Potato-eater/Legacy2026/README.md

# Legacy2026
github repo for Robocup Junior Australia lightweight soccer team

poster for state competition: https://canva.link/pb0ula68jbszzvj

All programs are annotated within their own files.
