Potato-eater/Legacy2026/robot_program/README.md

# legacy-robot-code
Legacy (RCJ Australian lightweight team)
repo for current robot code

Convention:
* all angles in radians (-PI - PI)
* all distance measurements in mm
* origin (0, 0) is centre of field

Note: 
* run "pio pkg update" to update all packages (SparkFun library requires latest version)
* ultrasonic classes have not been tested
