Potato-eater/Legacy2026/esp_programs/README.md

- all the programs that we have for the esp32 s2 units in the robot.
- the program for the ir sensor and line sensor.
- the other 2 programs are temporary testing projects. it can be ignored.
