Potato-eater/Legacy2026/pcbs/main_pcb_v2/production/bom.csv

Designator | Footprint | Quantity | Value | LCSC Part #
BT1, BT2, BT3 | Altronics_S5037 | 3 | 18650
C1 | 0805 | 1 | 10uF
C10 | 0402 | 1 | 0.1uF
C2, C3, C8, C9 | 0805 | 4 | 0.1uF
C4, C5 | 0805 | 2 | 22uF
C6 | 0805 | 1 | 75pF
CN1 | CONN-SMD_SM05B-SRSS-TB-LF-SN | 1 | MotorTL | C136657
CN2 | CONN-SMD_SM05B-SRSS-TB-LF-SN | 1 | MotorTR | C136657
CN3 | CONN-SMD_SM05B-SRSS-TB-LF-SN | 1 | MotorBL | C136657
CN4 | CONN-SMD_SM05B-SRSS-TB-LF-SN | 1 | MotorBR | C136657
CN5 | CONN-SMD_4P-P1.00_SM04B-SRSS-TB-LF-SN | 1 | OTOS | C160404
D1 | 0603 | 1 | MOTOR LED
D2, D5, D6, D7 | D_SMA | 4 | 1A Fast SMA
D3 | 0805 | 1 | OP LED
D4 | SMB_L4.6-W3.6-LS5.3-RD | 1 | SS34_C13762 | C13762
D8 | 0603 | 1 | MAIN LED
J1 | PinSocket_1x24_P2.54mm_Vertical | 1 | Teensy Left
J12 | PinSocket_1x06_P2.54mm_Vertical | 1 | BD Left
J13 | PinSocket_1x06_P2.54mm_Vertical | 1 | BD Right
J14 | JST_XH_B2B-XH-A_1x02_P2.50mm_Vertical | 1 | IR Sensor
J15 | JST_XH_B4B-XH-A_1x04_P2.50mm_Vertical | 1 | Line Sensor
J16 | JST_XH_B4B-XH-A_1x04_P2.50mm_Vertical | 1 | CAM
J17 | IDC-Header_2x05_P2.54mm_Vertical | 1 | Comm.
J2 | PinSocket_1x24_P2.54mm_Vertical | 1 | Teensy Right
J3 | PinSocket_1x05_P2.54mm_Vertical | 1 | EXTRA1
J4 | PinSocket_1x04_P2.54mm_Vertical | 1 | EXTRA2
J5 | PinSocket_1x04_P2.54mm_Vertical | 1 | EXTRA3
J6 | JST_XH_B2B-XH-A_1x02_P2.50mm_Vertical | 1 | DB_OUT
J7 | JST_XH_B2B-XH-A_1x02_P2.50mm_Vertical | 1 | EXTRA_I2C
J8 | PinSocket_1x03_P2.54mm_Vertical | 1 | Conn_01x03
L1 | IND-SMD_L11.0-W10.0 | 1 | 10uH
Q1 | WDFN-8_L3.0-W3.0-P0.65-LS3.3-BL-EP | 1 | AON7409 | C41348138
Q2 | DFN-8_L3.0-W3.0-P0.65-BL | 1 | AON7524 | C431195
R1 | 0603 | 1 | 49.9
R14, R7 | 0603 | 2 | 200R
R15, R2, R9 | 0603 | 3 | 100k
R3 | 0603 | 1 | 13.3k
R4 | 0603 | 1 | 511k
R5 | 0603 | 1 | 105k
R8 | 0603 | 1 | 33R
SW1, SW2, SW3 | CONN-TH_2P-P5.00_WJ128V-5.0-2P | 3 | SW_SPDT
U1 | SOT-23-6 | 1 | TPS54302
