Potato-eater/Legacy2026/pcbs/main_pcb/main_pcb.step

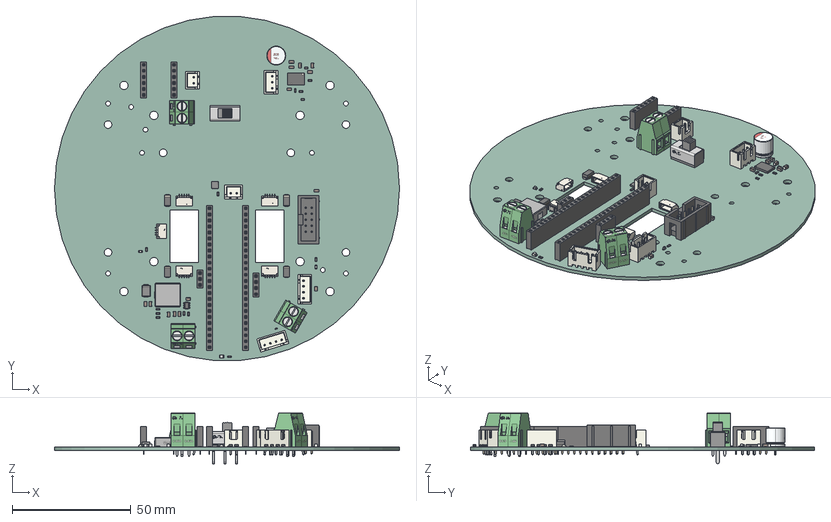
[picture p1: CAD file, 2026-09-28]
pcbs/main_pcb/main_pcb.step
145.0 x 144.6 x 21.2 mm
C_0805_2012Metric x 14
LED_0805_2012Metric
JST_XH_B2B-XH-A_1x02_P2.50mm_Vertical x 2
R_0603_1608Metric x 14
CONN-TH_2P-L10.0-W10.3-H14.1-P5.0 x 3
D_SMA x 4
SMB_L4.6-W3.6-LS5.3-RD
CONN-SMD_SR1.00-WS-5P x 4
LED_0603_1608Metric x 2
VQFN-40_L7.0-W5.0-P0.50-BL-EP5.7
IND-SMD_L11.0-W10.0-H4.0
PinSocket_1x06_P2.54mm_Vertical x 2
JST_XH_B4B-XH-A_1x04_P2.50mm_Vertical x 2
PinSocket_1x04_P2.54mm_Vertical
JST_XH_B3B-XH-A_1x03_P2.50mm_Vertical
CAP-TH_D8.0-H8.0-P3.50
SOT-23-6
SW-TH_SHOU-HAN_SS12D10G4
PinSocket_1x24_P2.54mm_Vertical x 2
DFN-8_L3.0-W3.0-H0.7-P0.65
IDC-Header_2x05_P2.54mm_Vertical
CONN-SMD_SR1.00-WS-4P
PinSocket_1x03_P2.54mm_Vertical
C_0402_1005Metric
main_pcb_PCB
