Potato-eater/Legacy2026/pcbs/control_board/control_board.step

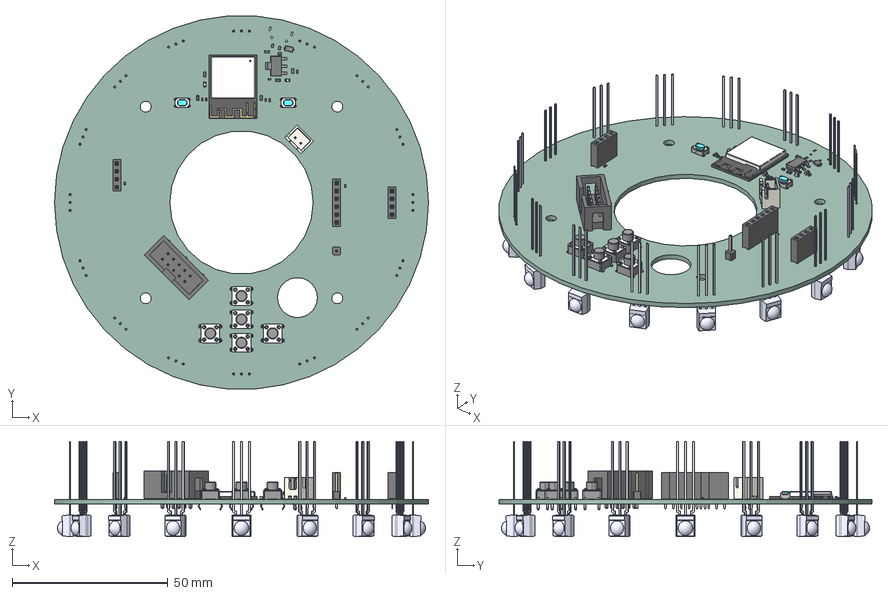
[picture p2: CAD file, 2026-09-28]
pcbs/control_board/control_board.step
120.0 x 119.7 x 30.5 mm
R_0603_1608Metric x 3
PinSocket_1x04_P2.54mm_Vertical x 2
LED_0603_1608Metric x 2
IDC-Header_2x05_P2.54mm_Vertical
MICRO-USB-SMD_5P-P0.65-H-F_C10418
JST_XH_B2B-XH-A_1x02_P2.50mm_Vertical
C_0402_1005Metric x 8
C_0603_1608Metric x 3
SOD-523_L1.2-W0.8-LS1.6-BI x 3
PinHeader_1x01_P2.54mm_Vertical
uid__9223372036865042093
R0201_20210301.xtd x 2
XTAL3225_20210301.xtd
L0201_20210301.xtd x 2
C0201_20210301.xtd x 15
ESP32-S2_20210301.xtd
DFN1006.xtd
C0402_20210301.xtd
Imported
MINI-ANT-TYPE-S-H_t
MINI-ANT-TYPE-S-H_b
ESP32-S3-S2-MINI-solder_pad
ShieldBox_ESP32-S2-MINI-1_V1.0_20200714
PinSocket_1x06_P2.54mm_Vertical
SW-SMD_4P_PTS810SJM250SMTRLFS x 2
SOD-123_L2.7-W1.6-H1.4-LS3.7
SOT-223
GO-100184_1 x 16
GO-100184.028 x 16
control_board_PCB
