Potato-eater/Legacy2026/(list of files, cad)

Other CAD files:
pcbs/control_board/control_board.stl
