Potato-eater/Legacy2026/pcbs/line_sensor/line_sensor.pdf

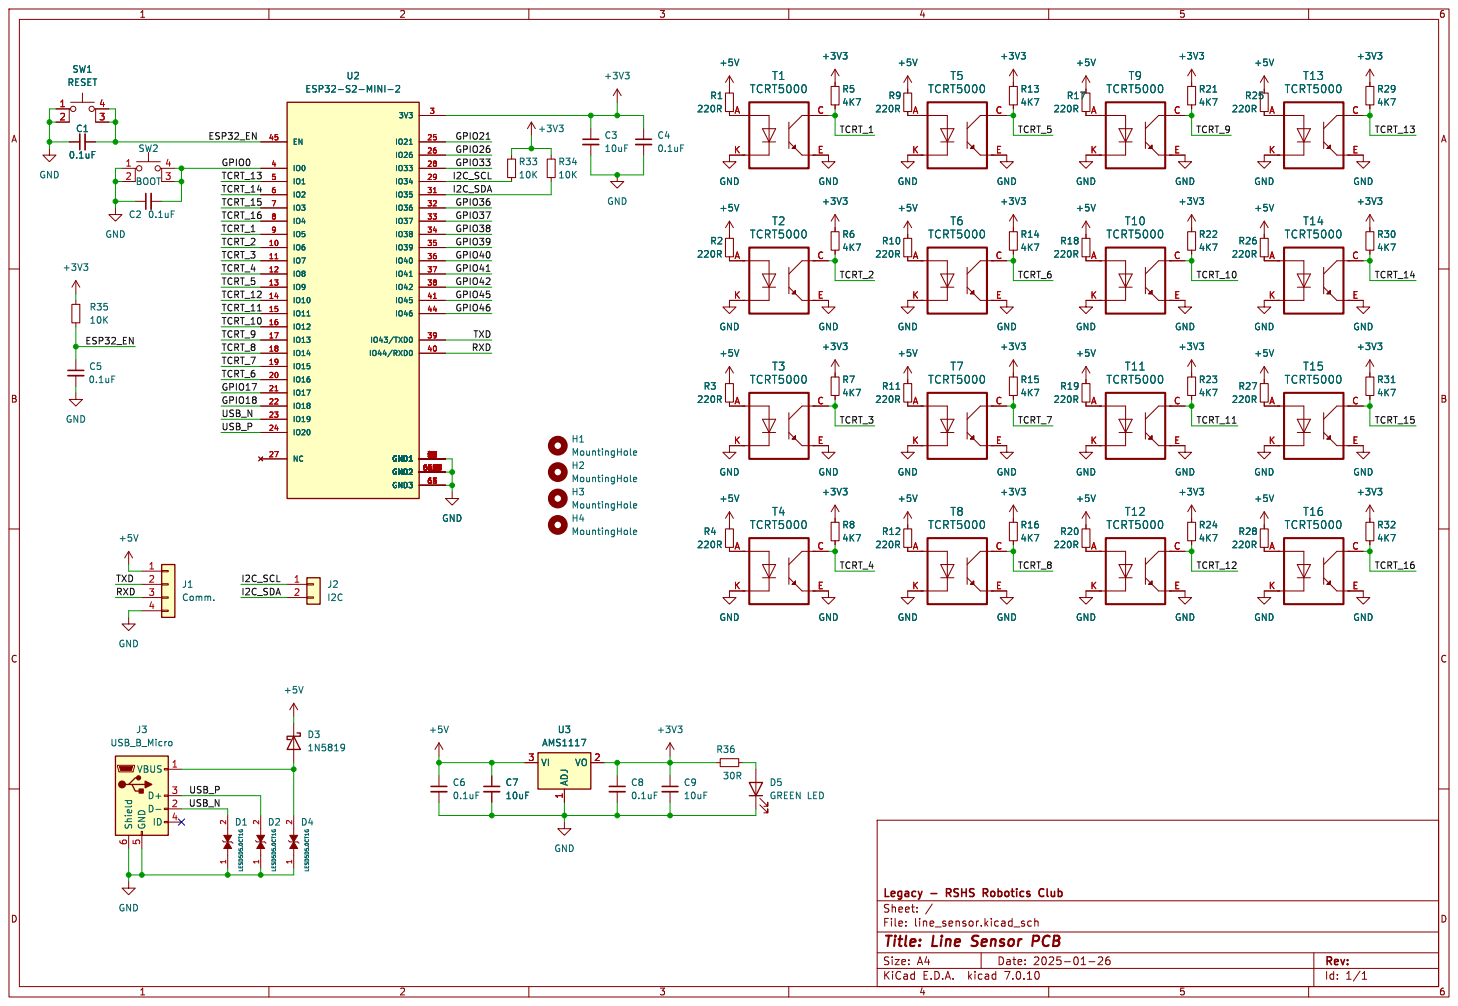
[picture p3: page 1]

Id: 1/1 Title: Line Sensor PCB
