Potato-eater/Legacy2026/pcbs/control_board/control_board.kicad_pcb

## KiCad design pcbs/control_board/control_board.kicad_pcb (2026-09-28)

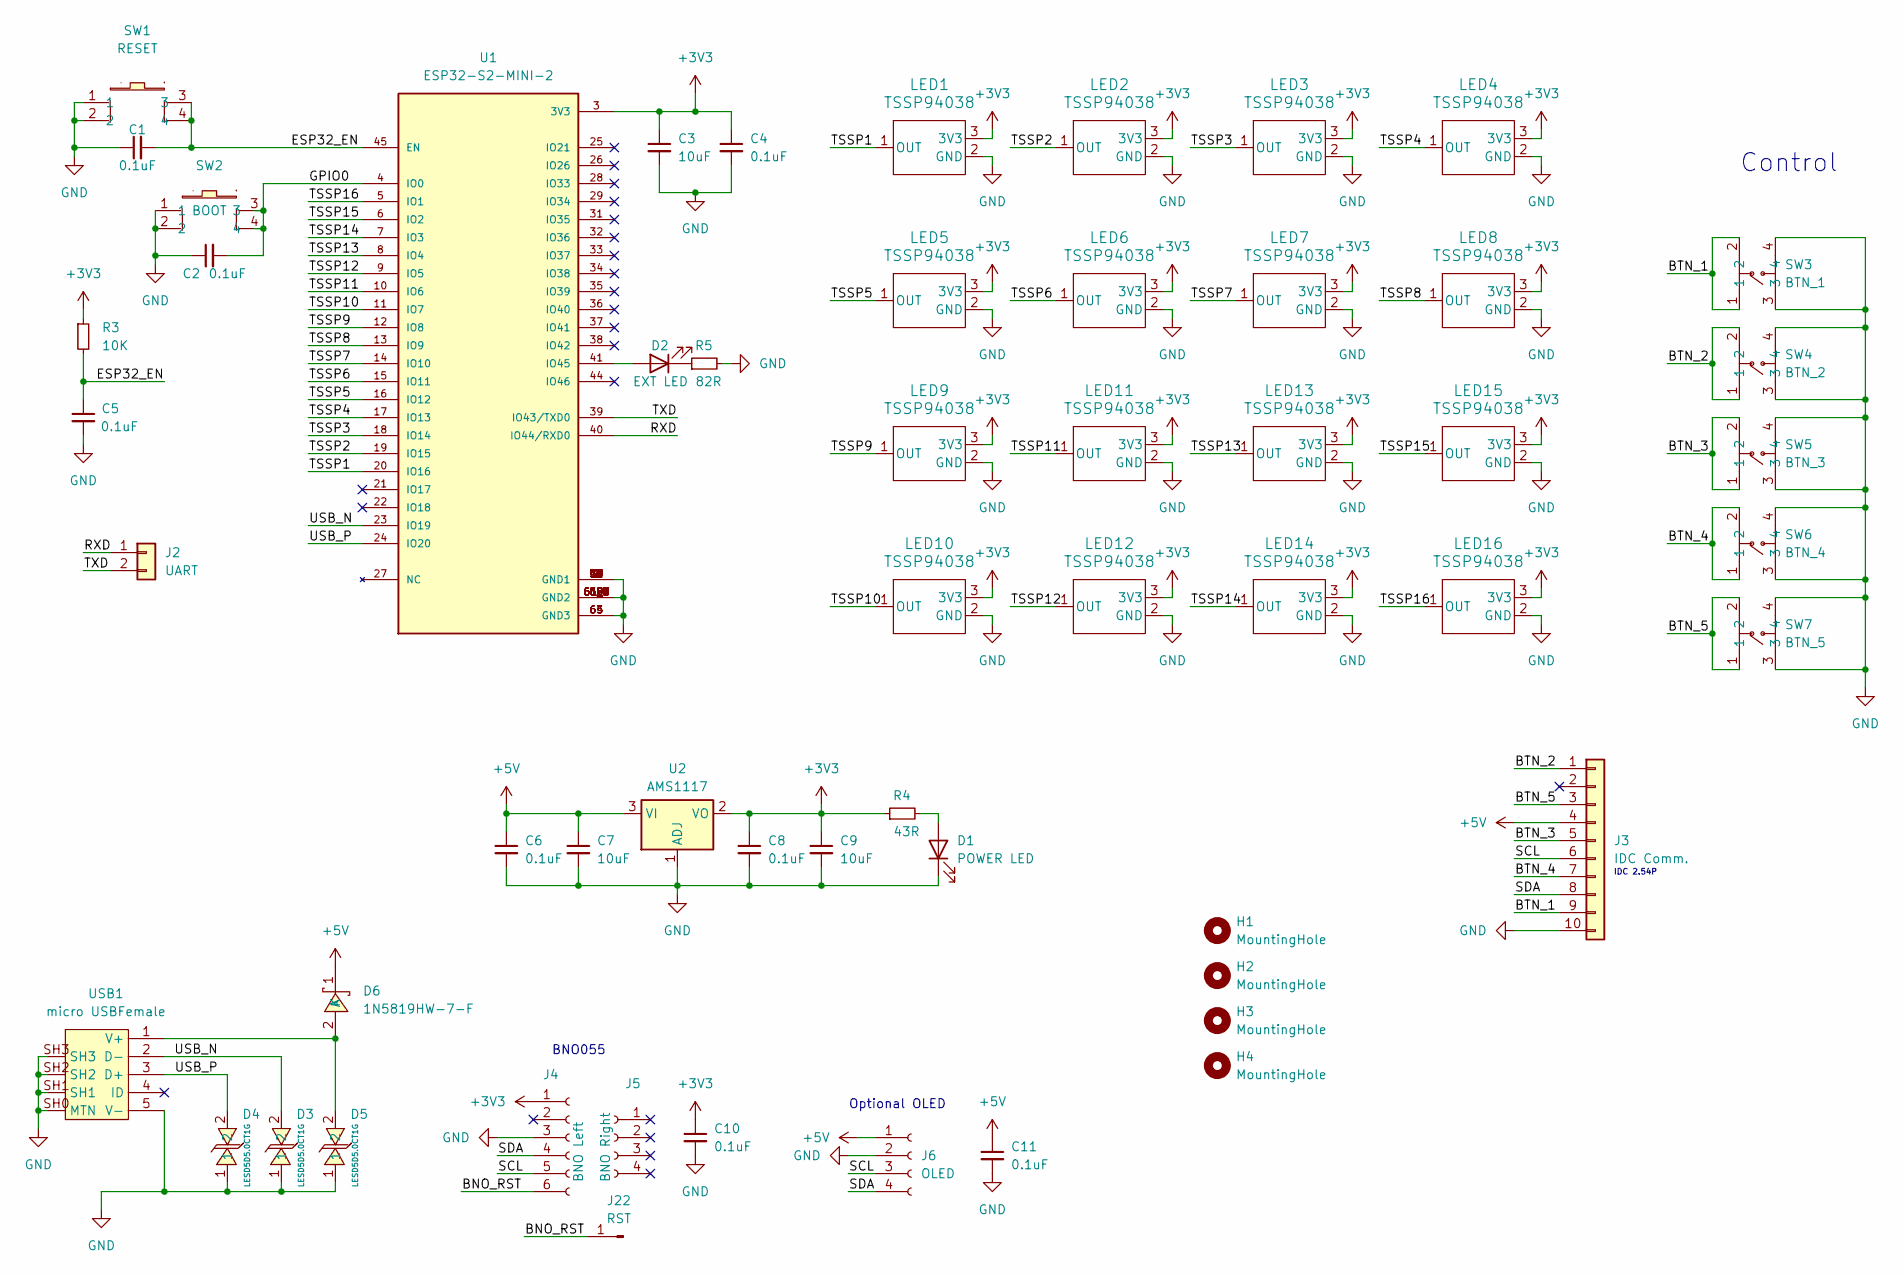
[picture p4: schematic control_board.kicad_sch]

Parts:
C1, C2, C4, C5, C6, C8, C10, C11: 0.1uF; C_0402_1005Metric
C3, C7, C9: 10uF; C_0603_1608Metric
D1: POWER LED; LED_0603_1608Metric
D2: EXT LED; LED_0603_1608Metric
D3, D4, D5: LESD5D5.0CT1G; SOD-523_L1.2-W0.8-LS1.6-BI; LCSC Part C5274290
D6: 1N5819HW-7-F; SOD-123_L2.7-W1.6-LS3.7-RD; LCSC Part C82544
H1, H2, H3, H4: MountingHole; MountingHole_3.5mm
J2: UART; JST_XH_B2B-XH-A_1x02_P2.50mm_Vertical
J3: IDC Comm.; IDC-Header_2x05_P2.54mm_Vertical
J4: BNO Left; PinSocket_1x06_P2.54mm_Vertical
J5: BNO Right; PinSocket_1x04_P2.54mm_Vertical
J6: OLED; PinSocket_1x04_P2.54mm_Vertical
J22: RST; PinHeader_1x01_P2.54mm_Vertical
LED1, LED2, LED3, LED4, LED5, LED6, LED7, LED8, LED9, LED10, LED11, LED12, LED13, LED14, LED15, LED16: TSSP94038
R3: 10K; R_0603_1608Metric
R4: 43R; R_0603_1608Metric
R5: 82R; R_0603_1608Metric
SW1: RESET; SW-SMD_4P_PTS810SJM250SMTRLFS; LCSC Part C221897
SW2: BOOT; SW-SMD_4P_PTS810SJM250SMTRLFS; LCSC Part C221897
SW3: BTN_1; SW-TH_4P-L6.0-W6.0-P4.50-LS6.3; LCSC Part C2889001
SW4: BTN_2; SW-TH_4P-L6.0-W6.0-P4.50-LS6.3; LCSC Part C2889001
SW5: BTN_3; SW-TH_4P-L6.0-W6.0-P4.50-LS6.3; LCSC Part C2889001
SW6: BTN_4; SW-TH_4P-L6.0-W6.0-P4.50-LS6.3; LCSC Part C2889001
SW7: BTN_5; SW-TH_4P-L6.0-W6.0-P4.50-LS6.3; LCSC Part C2889001
U1: ESP32-S2-MINI-2; PARTREV v0.5
U2: AMS1117; SOT-223-3_TabPin2
USB1: micro USBFemale; MICRO-USB-SMD_5P-P0.65-H-F_C10418; LCSC Part C10418

Connections:
+3V3: C3.1, C4.1, C8.1, C9.1, C10.1, J4.1, LED1.3 (3V3), LED2.3 (3V3), LED3.3 (3V3), LED4.3 (3V3), LED5.3 (3V3), LED6.3 (3V3), LED7.3 (3V3), LED8.3 (3V3), LED9.3 (3V3), LED10.3 (3V3), LED11.3 (3V3), LED12.3 (3V3), LED13.3 (3V3), LED14.3 (3V3), LED15.3 (3V3), LED16.3 (3V3), R3.1, R4.1, U1.3 (3V3), U2.2 (VO)
+5V: C6.1, C7.1, C11.1, D6.1 (K), J3.4, J6.1, U2.3 (VI)
/BNO_RST: J4.6, J22.1
/BTN_1: J3.9, SW3.1, SW3.2
/BTN_2: J3.1, SW4.1, SW4.2
/BTN_3: J3.5, SW5.1, SW5.2
/BTN_4: J3.7, SW6.1, SW6.2
/BTN_5: J3.3, SW7.1, SW7.2
/ESP32_EN: C1.2, C5.1, R3.2, SW1.3, SW1.4, U1.45 (EN)
/GPIO0: C2.2, SW2.3, SW2.4, U1.4 (IO0)
/RXD: J2.1, U1.40 (IO44/RXD0)
/SCL: J3.6, J4.5, J6.3
/SDA: J3.8, J4.4, J6.4
/TSSP1: LED1.1 (OUT), U1.20 (IO16)
/TSSP2: LED2.1 (OUT), U1.19 (IO15)
/TSSP3: LED3.1 (OUT), U1.18 (IO14)
/TSSP4: LED4.1 (OUT), U1.17 (IO13)
/TSSP5: LED5.1 (OUT), U1.16 (IO12)
/TSSP6: LED6.1 (OUT), U1.15 (IO11)
/TSSP7: LED7.1 (OUT), U1.14 (IO10)
/TSSP8: LED8.1 (OUT), U1.13 (IO9)
/TSSP9: LED9.1 (OUT), U1.12 (IO8)
/TSSP10: LED10.1 (OUT), U1.11 (IO7)
/TSSP11: LED11.1 (OUT), U1.10 (IO6)
/TSSP12: LED12.1 (OUT), U1.9 (IO5)
/TSSP13: LED13.1 (OUT), U1.8 (IO4)
/TSSP14: LED14.1 (OUT), U1.7 (IO3)
/TSSP15: LED15.1 (OUT), U1.6 (IO2)
/TSSP16: LED16.1 (OUT), U1.5 (IO1)
/TXD: J2.2, U1.39 (IO43/TXD0)
/USB_N: D3.2, U1.23 (IO19), USB1.2 (D-)
/USB_P: D4.2, U1.24 (IO20), USB1.3 (D+)
GND: C1.1, C2.1, C3.2, C4.2, C5.2, C6.2, C7.2, C8.2, C9.2, C10.2, C11.2, D1.1 (K), D3.1, D4.1, D5.1, J3.10, J4.3, J6.2, LED1.2 (GND), LED2.2 (GND), LED3.2 (GND), LED4.2 (GND), LED5.2 (GND), LED6.2 (GND), LED7.2 (GND), LED8.2 (GND), LED9.2 (GND), LED10.2 (GND), LED11.2 (GND), LED12.2 (GND), LED13.2 (GND), LED14.2 (GND), LED15.2 (GND), LED16.2 (GND), R5.2, SW1.1, SW1.2, SW2.1, SW2.2, SW3.3, SW3.4, SW4.3, SW4.4, SW5.3, SW5.4, SW6.3, SW6.4, SW7.3, SW7.4, U1.1 (GND1), U1.2 (GND1), U1.30 (GND1), U1.42 (GND1), U1.43 (GND1), U1.46 (GND1), U1.47 (GND1), U1.48 (GND1), U1.49 (GND1), U1.50 (GND1), U1.51 (GND1), U1.52 (GND1), U1.53 (GND1), U1.54 (GND1), U1.55 (GND1), U1.56 (GND2), U1.57 (GND2), U1.58 (GND2), U1.59 (GND2), U1.60 (GND2), U1.61_1 (GND2), U1.61_2 (GND2), U1.61_3 (GND2), U1.61_4 (GND2), U1.61_5 (GND2), U1.61_6 (GND2), U1.61_7 (GND2), U1.61_8 (GND2), U1.61_9 (GND2), U1.62 (GND2), U1.63 (GND3), U1.64 (GND3), U1.65 (GND3), U2.1 (ADJ), USB1.5 (V-), USB1.SH0 (MTN), USB1.SH1, USB1.SH2, USB1.SH3
unnamed: D1.2 (A), R4.2
unnamed: D2.2 (A), U1.41 (IO45)
unnamed: D2.1 (K), R5.1
unnamed: D5.2, D6.2 (A), USB1.1 (V+)

Notes on the sheet:
Optional OLED
Control
BNO055
IDC 2.54P

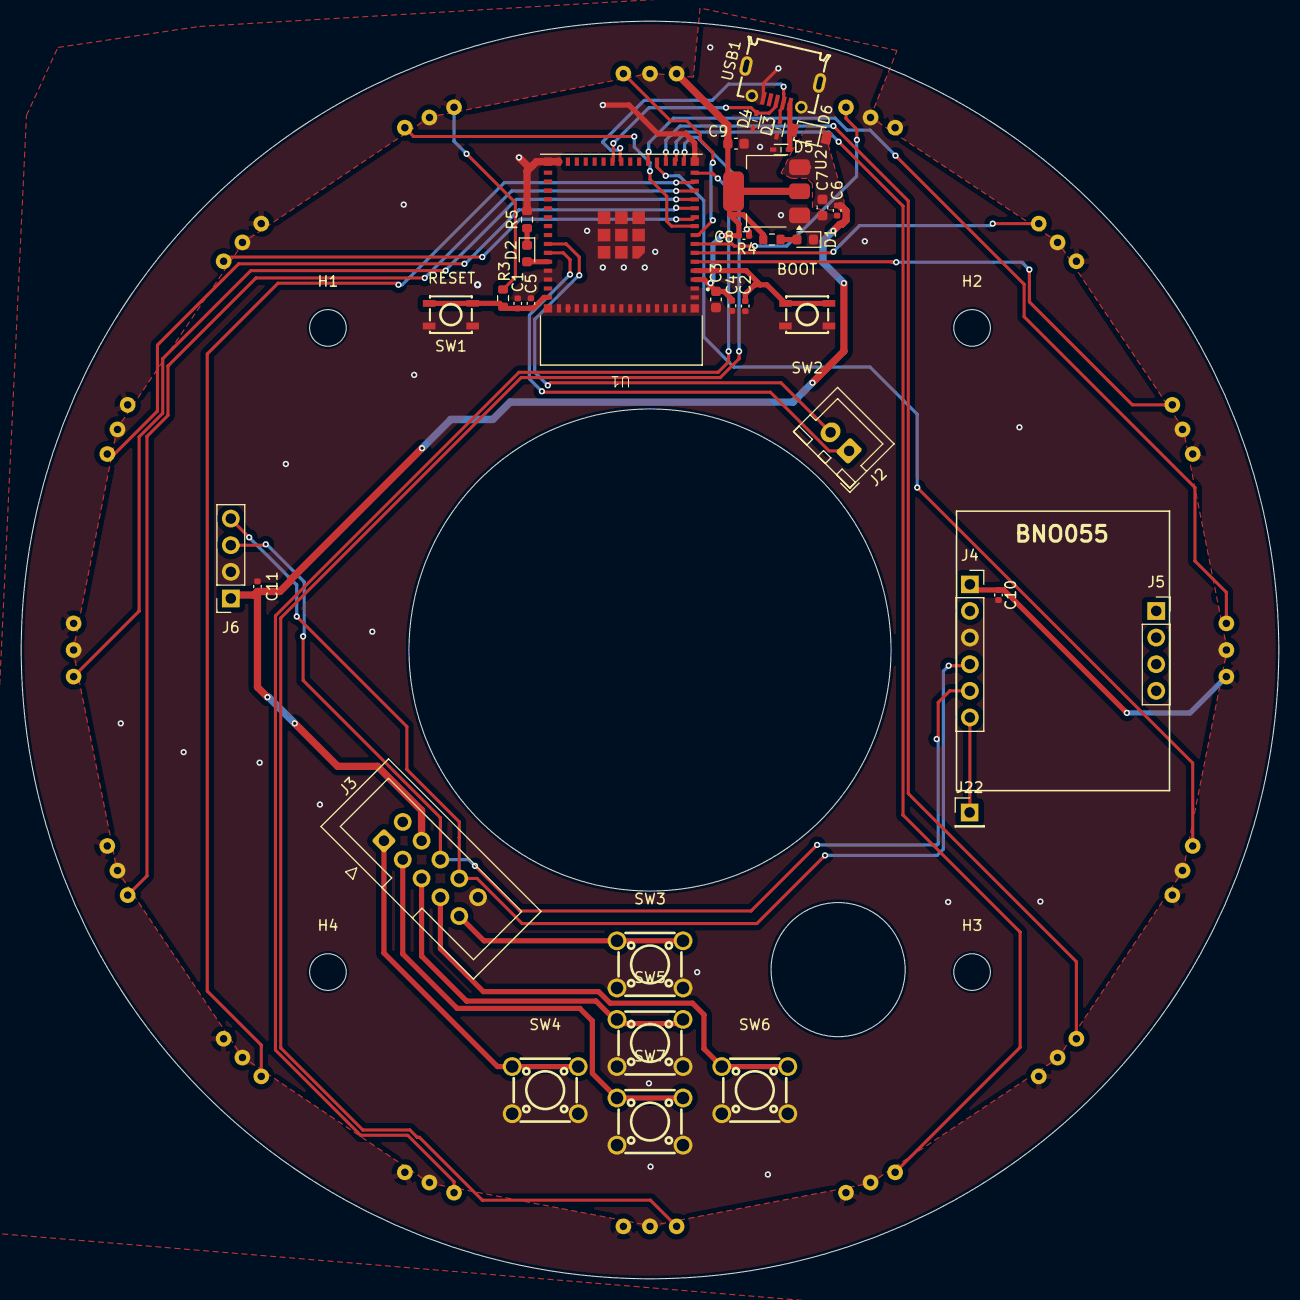
[picture p5: board control_board.kicad_pcb from above]

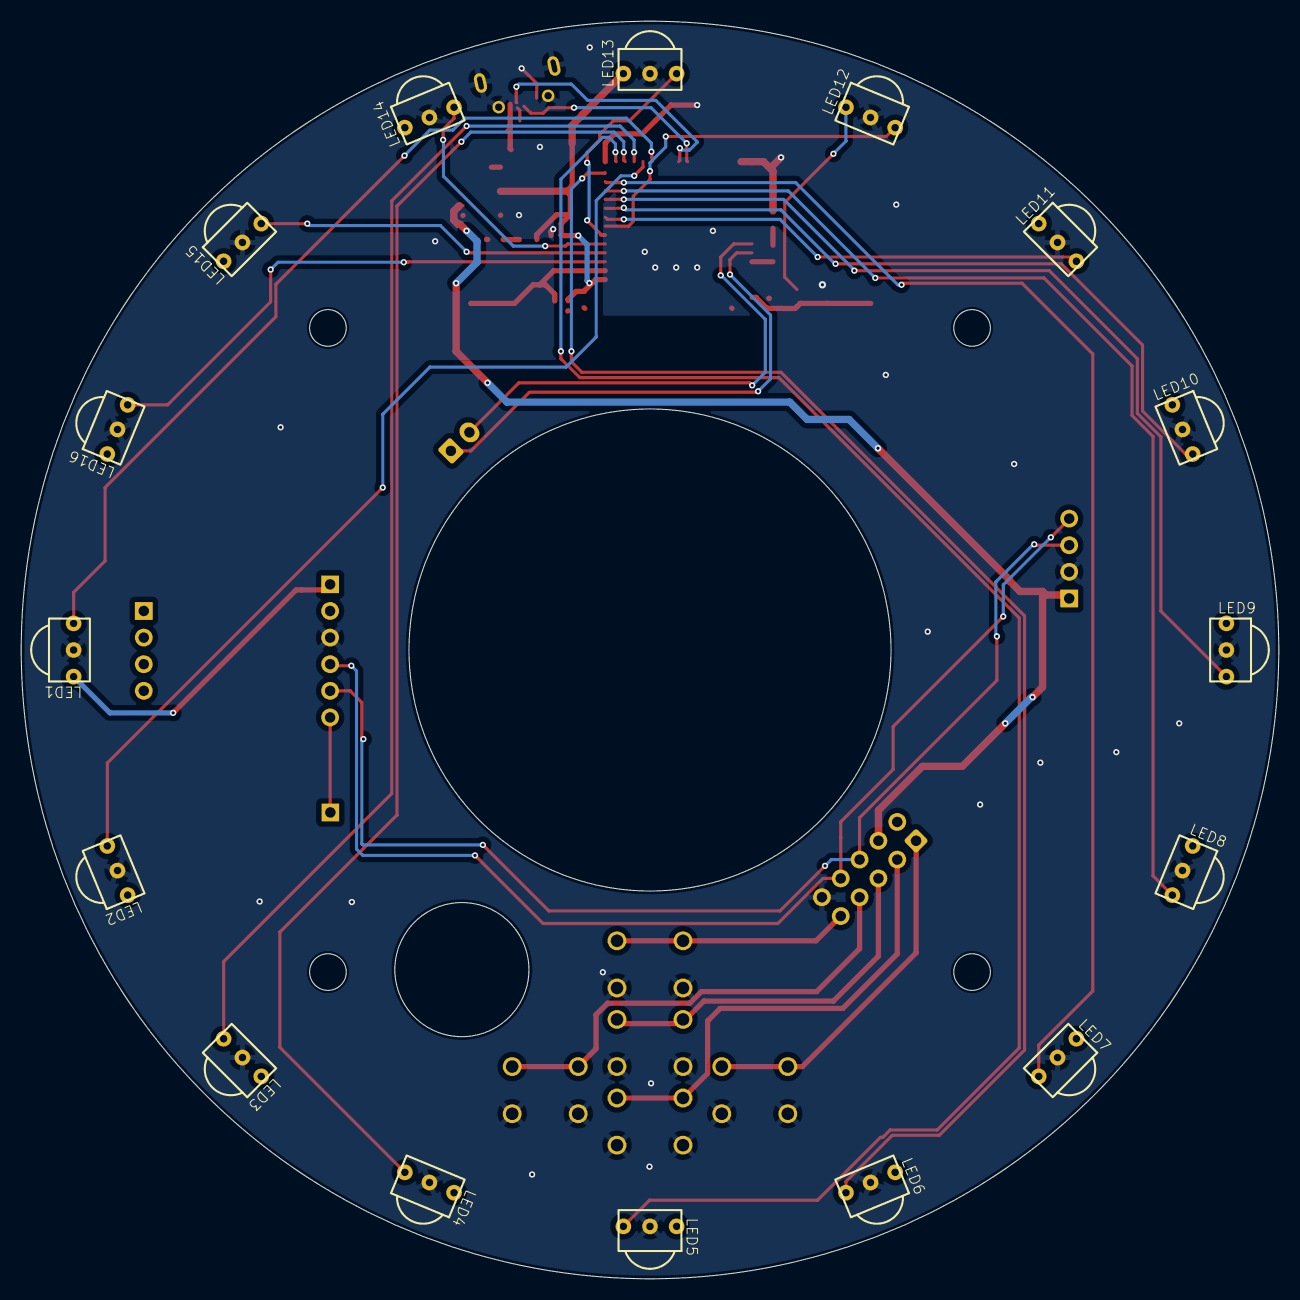
[picture p6: board control_board.kicad_pcb from below]

Board: 2 copper layers, 120.0 x 120.0 mm, 56 parts (16 on the bottom side), 37 nets.
