Potato-eater/Legacy2026/pcbs/main_pcb_v2/main_pcb_v2.kicad_pcb

## KiCad design pcbs/main_pcb_v2/main_pcb_v2.kicad_pcb (2026-09-28)

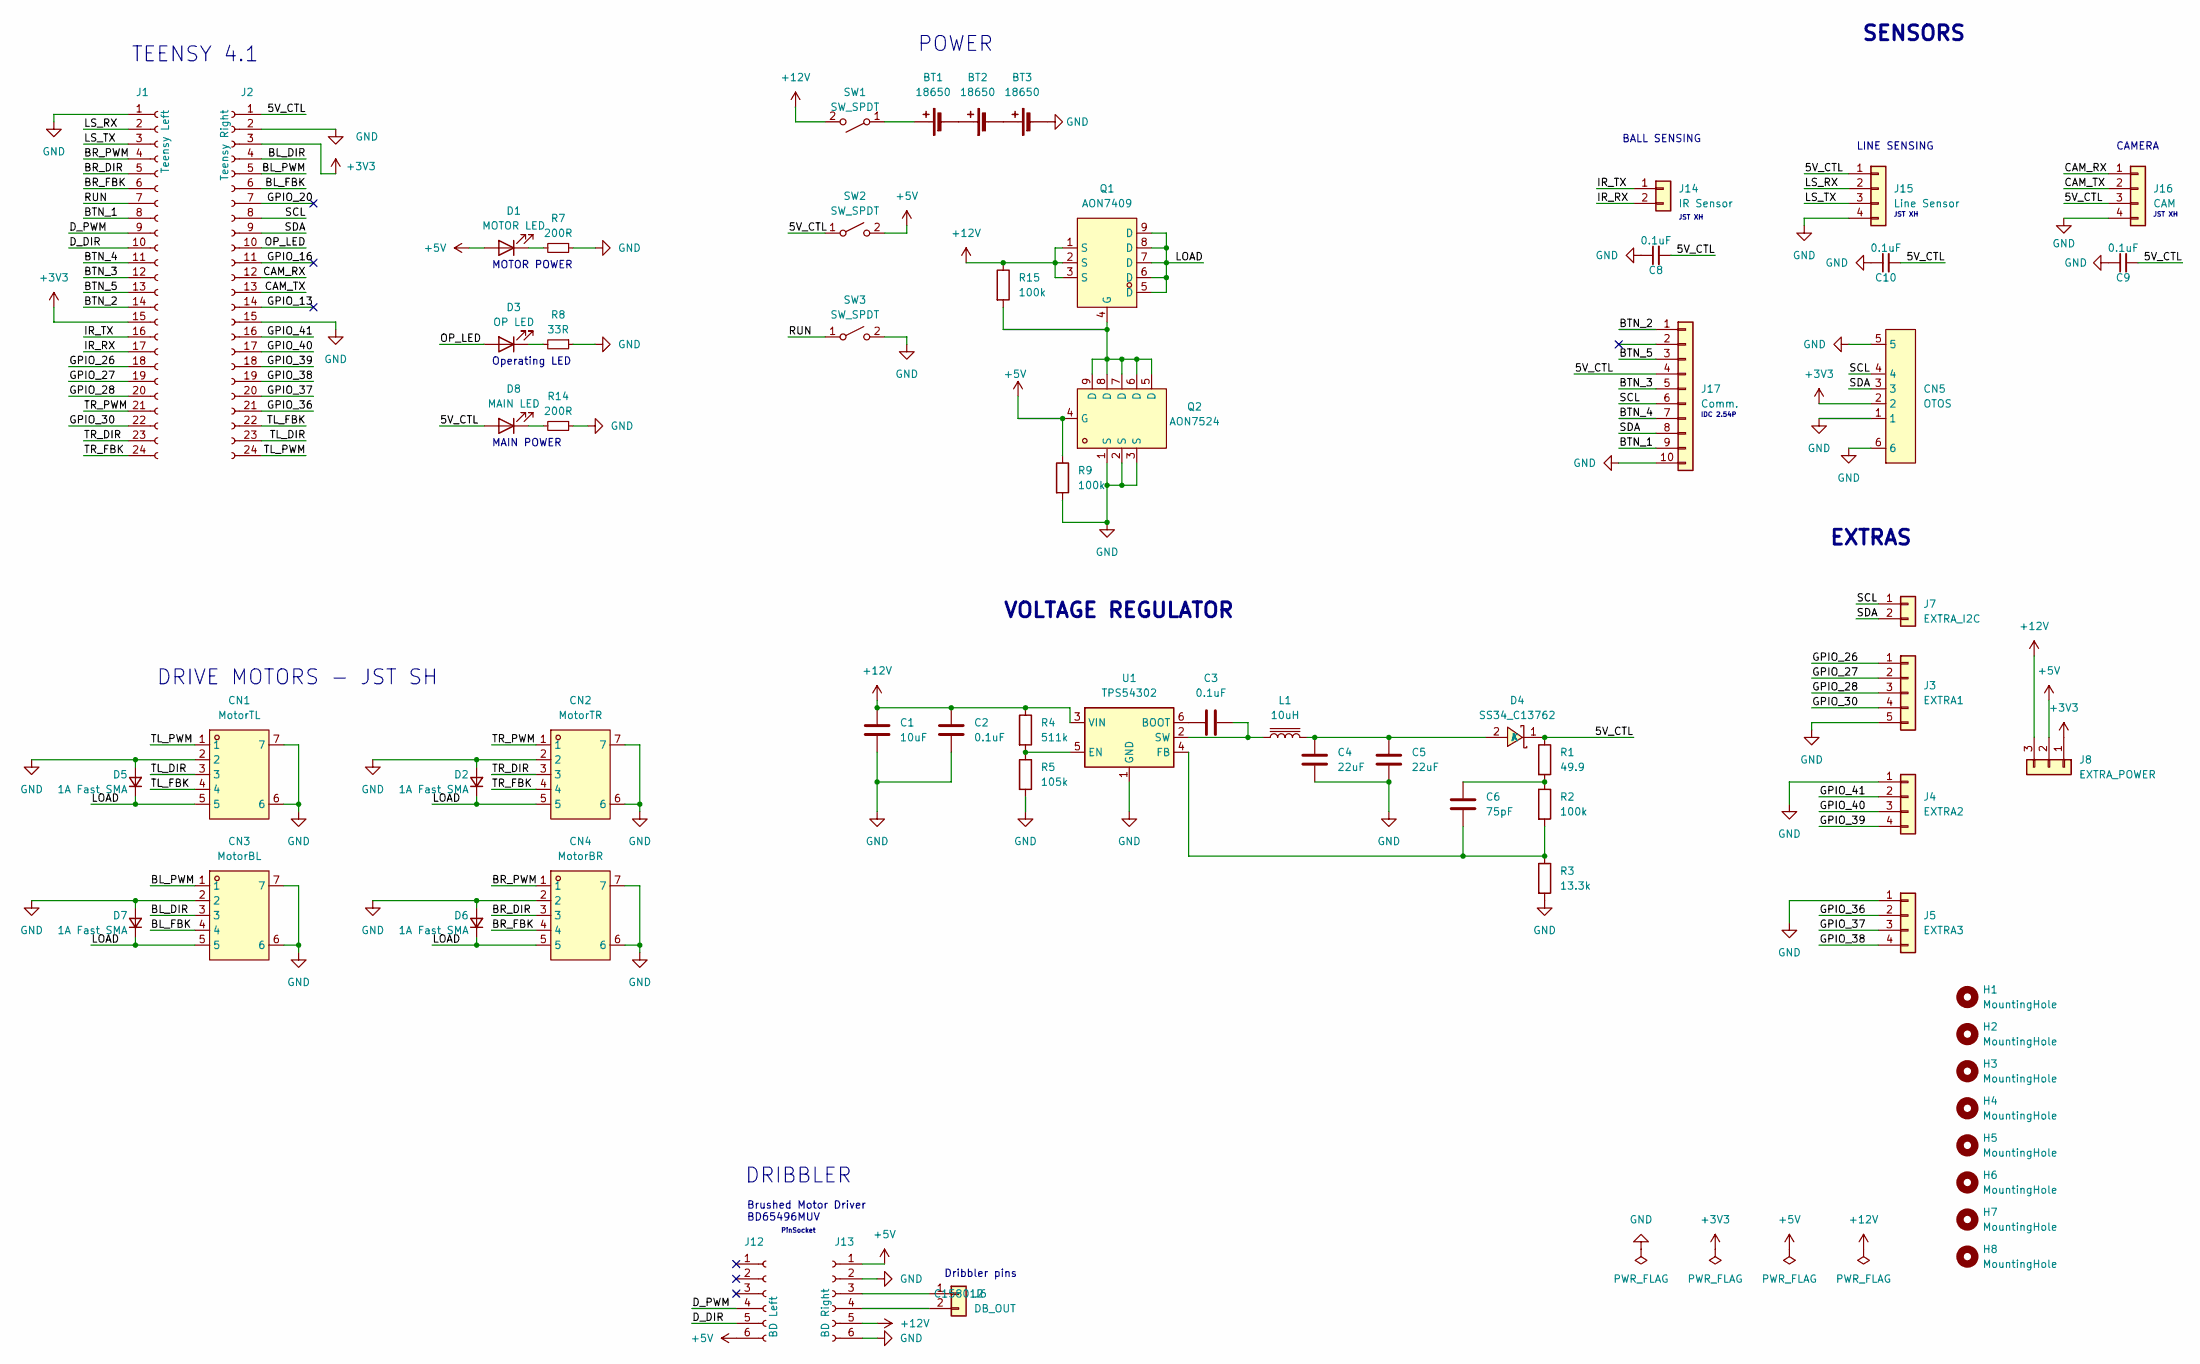
[picture p7: schematic main_pcb_v2.kicad_sch, Team Legacy 2026 Main Board V2]

Parts:
BT1, BT2, BT3: 18650; Altronics_S5037
C1: 10uF; C_0805_2012Metric
C2, C3, C8, C9: 0.1uF; C_0805_2012Metric
C4, C5: 22uF; C_0805_2012Metric
C6: 75pF; C_0805_2012Metric
C10: 0.1uF; C_0402_1005Metric
CN1: MotorTL; CONN-SMD_SM05B-SRSS-TB-LF-SN; LCSC Part C136657
CN2: MotorTR; CONN-SMD_SM05B-SRSS-TB-LF-SN; LCSC Part C136657
CN3: MotorBL; CONN-SMD_SM05B-SRSS-TB-LF-SN; LCSC Part C136657
CN4: MotorBR; CONN-SMD_SM05B-SRSS-TB-LF-SN; LCSC Part C136657
CN5: OTOS; CONN-SMD_4P-P1.00_SM04B-SRSS-TB-LF-SN; LCSC Part C160404
D1: MOTOR LED; LED_0603_1608Metric
D2, D5, D6, D7: 1A Fast SMA; D_SMA
D3: OP LED; LED_0805_2012Metric
D4: SS34_C13762; SMB_L4.6-W3.6-LS5.3-RD; LCSC Part C13762
D8: MAIN LED; LED_0603_1608Metric
H1, H2, H3, H4, H5, H6, H7, H8: MountingHole; MountingHole_3.5mm
J1: Teensy Left; PinSocket_1x24_P2.54mm_Vertical
J2: Teensy Right; PinSocket_1x24_P2.54mm_Vertical
J3: EXTRA1; PinSocket_1x05_P2.54mm_Vertical
J4: EXTRA2; PinSocket_1x04_P2.54mm_Vertical
J5: EXTRA3; PinSocket_1x04_P2.54mm_Vertical
J6: DB_OUT; JST_XH_B2B-XH-A_1x02_P2.50mm_Vertical
J7: EXTRA_I2C; JST_XH_B2B-XH-A_1x02_P2.50mm_Vertical
J8: EXTRA_POWER; PinSocket_1x03_P2.54mm_Vertical
J12: BD Left; PinSocket_1x06_P2.54mm_Vertical
J13: BD Right; PinSocket_1x06_P2.54mm_Vertical
J14: IR Sensor; JST_XH_B2B-XH-A_1x02_P2.50mm_Vertical
J15: Line Sensor; JST_XH_B4B-XH-A_1x04_P2.50mm_Vertical
J16: CAM; JST_XH_B4B-XH-A_1x04_P2.50mm_Vertical
J17: Comm.; IDC-Header_2x05_P2.54mm_Vertical
L1: 10uH; IND-SMD_L11.0-W10.0
Q1: AON7409; WDFN-8_L3.0-W3.0-P0.65-LS3.3-BL-EP; MPN AON7409; LCSC Part C41348138
Q2: AON7524; DFN-8_L3.0-W3.0-P0.65-BL; LCSC Part C431195
R1: 49.9; R_0603_1608Metric
R2, R9, R15: 100k; R_0603_1608Metric
R3: 13.3k; R_0603_1608Metric
R4: 511k; R_0603_1608Metric
R5: 105k; R_0603_1608Metric
R7, R14: 200R; R_0603_1608Metric
R8: 33R; R_0603_1608Metric
SW1, SW2, SW3: SW_SPDT; CONN-TH_2P-P5.00_WJ128V-5.0-2P
U1: TPS54302; SOT-23-6

Connections:
+3V3: CN5.2, J1.15, J2.3, J8.1
+5V: D1.2 (A), J8.2, J12.6, J13.1, Q2.4 (G), R9.1, SW2.2 (B)
+12V: C1.1, C2.1, J8.3, J13.5, Q1.1 (S), Q1.2 (S), Q1.3 (S), R4.1, R15.1, SW1.2 (B), U1.3 (VIN)
/5V_CTL: C8.2, C9.2, C10.2, D4.1 (K), D8.2 (A), J2.1, J15.1, J16.3, J17.4, R1.1, SW2.1 (A)
/BL_DIR: CN3.3, J2.4
/BL_FBK: CN3.4, J2.6
/BL_PWM: CN3.1, J2.5
/BR_DIR: CN4.3, J1.5
/BR_FBK: CN4.4, J1.6
/BR_PWM: CN4.1, J1.4
/BTN_1: J1.8, J17.9
/BTN_2: J1.14, J17.1
/BTN_3: J1.12, J17.5
/BTN_4: J1.11, J17.7
/BTN_5: J1.13, J17.3
/CAM_RX: J2.12, J16.1
/CAM_TX: J2.13, J16.2
/D_DIR: J1.10, J12.5
/D_PWM: J1.9, J12.4
/GPIO_13: J2.14
/GPIO_16: J2.11
/GPIO_20: J2.7
/GPIO_26: J1.18, J3.1
/GPIO_27: J1.19, J3.2
/GPIO_28: J1.20, J3.3
/GPIO_30: J1.22, J3.4
/GPIO_36: J2.21, J5.2
/GPIO_37: J2.20, J5.3
/GPIO_38: J2.19, J5.4
/GPIO_39: J2.18, J4.4
/GPIO_40: J2.17, J4.3
/GPIO_41: J2.16, J4.2
/IR_RX: J1.17, J14.2
/IR_TX: J1.16, J14.1
/LOAD: CN1.5, CN2.5, CN3.5, CN4.5, D2.1 (K), D5.1 (K), D6.1 (K), D7.1 (K), Q1.5 (D), Q1.6 (D), Q1.7 (D), Q1.8 (D), Q1.9 (D)
/LS_RX: J1.2, J15.2
/LS_TX: J1.3, J15.3
/OP_LED: D3.2 (A), J2.10
/RUN: J1.7, SW3.1 (A)
/SCL: CN5.4, J2.8, J7.1, J17.6
/SDA: CN5.3, J2.9, J7.2, J17.8
/TL_DIR: CN1.3, J2.23
/TL_FBK: CN1.4, J2.22
/TL_PWM: CN1.1, J2.24
/TR_DIR: CN2.3, J1.23
/TR_FBK: CN2.4, J1.24
/TR_PWM: CN2.1, J1.21
GND: BT3.2 (-), C1.2, C2.2, C4.1, C5.1, C8.1, C9.1, C10.1, CN1.2, CN1.6, CN1.7, CN2.2, CN2.6, CN2.7, CN3.2, CN3.6, CN3.7, CN4.2, CN4.6, CN4.7, CN5.1, CN5.5, CN5.6, D2.2 (A), D5.2 (A), D6.2 (A), D7.2 (A), J1.1, J2.2, J2.15, J3.5, J4.1, J5.1, J13.2, J13.6, J15.4, J16.4, J17.10, Q2.1 (S), Q2.2 (S), Q2.3 (S), R3.2, R5.2, R7.1, R8.1, R9.2, R14.1, SW3.2 (B), U1.1 (GND)
unnamed: BT1.1 (+), SW1.1 (A)
unnamed: BT1.2 (-), BT2.1 (+)
unnamed: BT2.2 (-), BT3.1 (+)
unnamed: C6.2, R1.2, R2.1
unnamed: D1.1 (K), R7.2
unnamed: D3.1 (K), R8.2
unnamed: C4.2, C5.2, D4.2 (A), L1.2
unnamed: D8.1 (K), R14.2
unnamed: J6.1, J13.3
unnamed: J6.2, J13.4
unnamed: Q1.4 (G), Q2.5 (D), Q2.6 (D), Q2.7 (D), Q2.8 (D), Q2.9 (D), R15.2
unnamed: C3.1, U1.6 (BOOT)
unnamed: R4.2, R5.1, U1.5 (EN)
unnamed: C6.1, R2.2, R3.1, U1.4 (FB)
unnamed: C3.2, L1.1, U1.2 (SW)

Notes on the sheet:
PinSocket
JST XH
CAMERA
MAIN POWER
BALL SENSING
Dribbler pins
DRIBBLER
VOLTAGE REGULATOR
DRIVE MOTORS - JST SH
SENSORS
Operating LED
LINE SENSING
IDC 2.54P
Brushed Motor Driver BD65496MUV
EXTRAS
TEENSY 4.1
POWER
MOTOR POWER

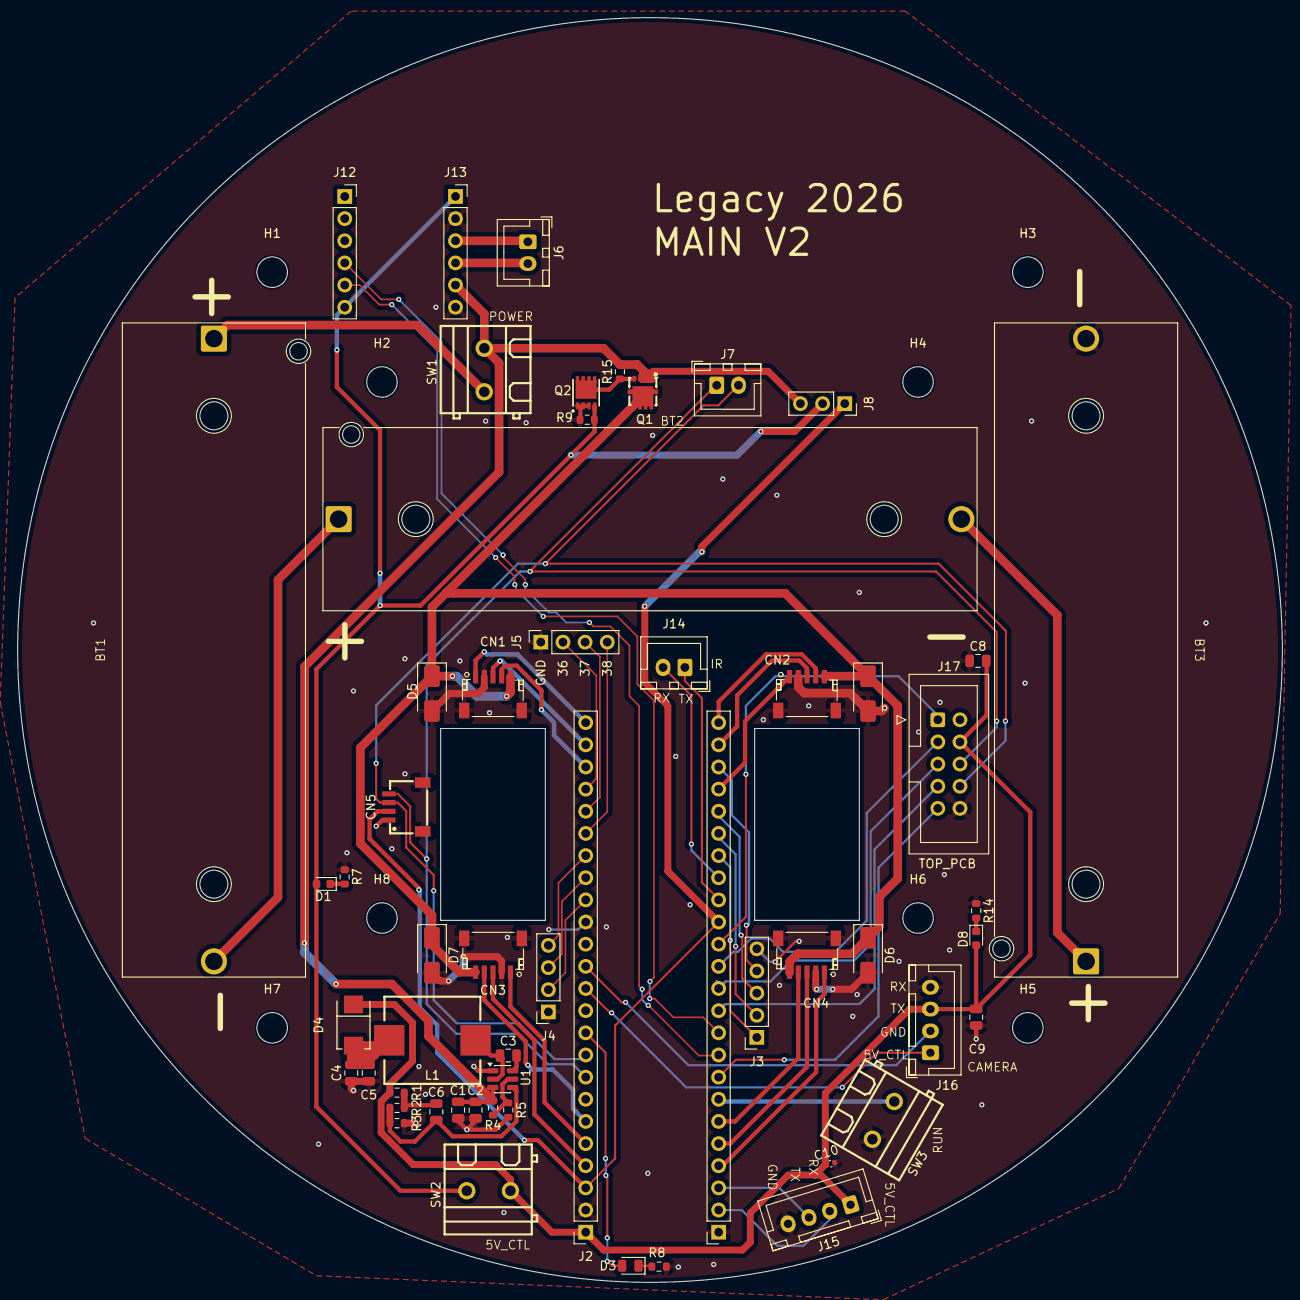
[picture p8: board main_pcb_v2.kicad_pcb from above]

Board: 2 copper layers, 145.0 x 145.0 mm, 64 parts (0 on the bottom side), 60 nets.
