Potato-eater/Legacy2026/pcbs/line_sensor/line_sensor.kicad_pcb

## KiCad design pcbs/line_sensor/line_sensor.kicad_pcb (2026-09-28)

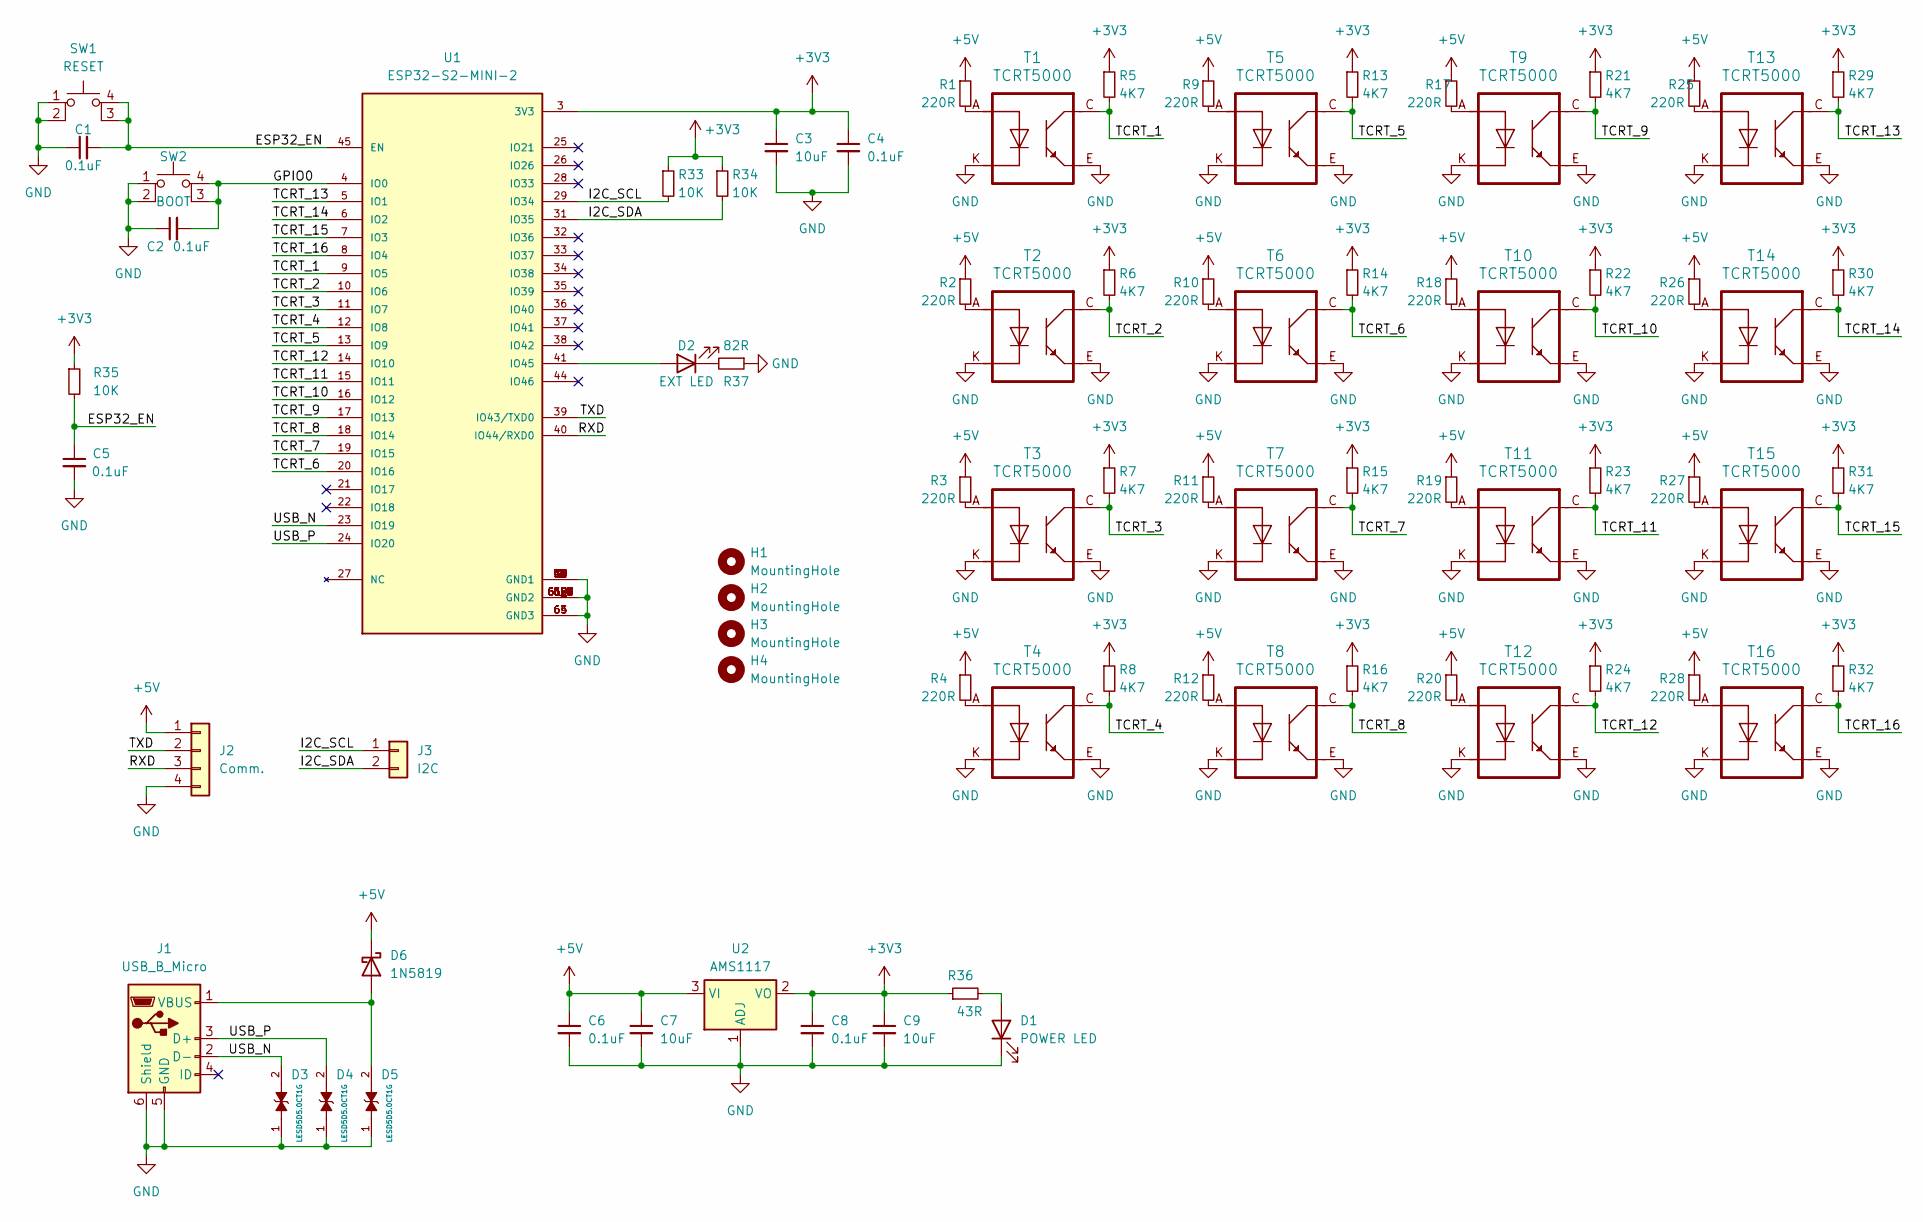
[picture p9: schematic line_sensor.kicad_sch, Line Sensor PCB]

Parts:
C1, C2, C4, C5, C6, C8: 0.1uF; C_0402_1005Metric
C3, C7, C9: 10uF; C_0603_1608Metric
D1: POWER LED; LED_0603_1608Metric
D2: EXT LED; LED_0603_1608Metric
D3, D4, D5: LESD5D5.0CT1G; TVS_LESD5D5.0CT1G; PARTREV O
D6: 1N5819; D_SOD-123
H1, H2, H3, H4: MountingHole; MountingHole_3.2mm_M3_Pad
J1: USB_B_Micro; C10418
J2: Comm.; JST_XH_B4B-XH-A_1x04_P2.50mm_Vertical
J3: I2C; JST_XH_B2B-XH-A_1x02_P2.50mm_Vertical
R1, R2, R3, R4, R9, R10, R11, R12, R17, R18, R19, R20, R25, R26, R27, R28: 220R; R_0603_1608Metric
R5, R6, R7, R8, R13, R14, R15, R16, R21, R22, R23, R24, R29, R30, R31, R32: 4K7; R_0603_1608Metric
R33, R34, R35: 10K; R_0603_1608Metric
R36: 43R; R_0603_1608Metric
R37: 82R; C_0603_1608Metric
SW1: RESET; SW_SPST_PTS810
SW2: BOOT; SW_SPST_PTS810
T1, T2, T3, T4, T5, T6, T7, T8, T9, T10, T11, T12, T13, T14, T15, T16: TCRT5000
U1: ESP32-S2-MINI-2; XCVR_ESP32-S2-MINI-2; PARTREV v0.5
U2: AMS1117; SOT-223-3_TabPin2

Connections:
+3V3: C3.1, C4.1, C8.1, C9.1, R5.1, R6.1, R7.1, R8.1, R13.1, R14.1, R15.1, R16.1, R21.1, R22.1, R23.1, R24.1, R29.1, R30.1, R31.1, R32.1, R33.1, R34.1, R35.1, R36.1, U1.3 (3V3), U2.2 (VO)
+5V: C6.1, C7.1, D6.1 (K), J2.1, R1.1, R2.1, R3.1, R4.1, R9.1, R10.1, R11.1, R12.1, R17.1, R18.1, R19.1, R20.1, R25.1, R26.1, R27.1, R28.1, U2.3 (VI)
/ESP32_EN: C1.2, C5.1, R35.2, SW1.3 (K), SW1.4 (A), U1.45 (EN)
/GPIO0: C2.2, SW2.3 (K), SW2.4 (A), U1.4 (IO0)
/I2C_SCL: J3.1, R33.2, U1.29 (IO34)
/I2C_SDA: J3.2, R34.2, U1.31 (IO35)
/RXD: J2.3, U1.40 (IO44/RXD0)
/TCRT_1: R5.2, T1.C (Collector), U1.9 (IO5)
/TCRT_2: R6.2, T2.C (Collector), U1.10 (IO6)
/TCRT_3: R7.2, T3.C (Collector), U1.11 (IO7)
/TCRT_4: R8.2, T4.C (Collector), U1.12 (IO8)
/TCRT_5: R13.2, T5.C (Collector), U1.13 (IO9)
/TCRT_6: R14.2, T6.C (Collector), U1.20 (IO16)
/TCRT_7: R15.2, T7.C (Collector), U1.19 (IO15)
/TCRT_8: R16.2, T8.C (Collector), U1.18 (IO14)
/TCRT_9: R21.2, T9.C (Collector), U1.17 (IO13)
/TCRT_10: R22.2, T10.C (Collector), U1.16 (IO12)
/TCRT_11: R23.2, T11.C (Collector), U1.15 (IO11)
/TCRT_12: R24.2, T12.C (Collector), U1.14 (IO10)
/TCRT_13: R29.2, T13.C (Collector), U1.5 (IO1)
/TCRT_14: R30.2, T14.C (Collector), U1.6 (IO2)
/TCRT_15: R31.2, T15.C (Collector), U1.7 (IO3)
/TCRT_16: R32.2, T16.C (Collector), U1.8 (IO4)
/TXD: J2.2, U1.39 (IO43/TXD0)
/USB_N: D3.2, J1.2 (D-), U1.23 (IO19)
/USB_P: D4.2, J1.3 (D+), U1.24 (IO20)
GND: C1.1, C2.1, C3.2, C4.2, C5.2, C6.2, C7.2, C8.2, C9.2, D1.1 (K), D3.1, D4.1, D5.1, J1.5 (GND), J1.6 (Shield), J2.4, R37.1, SW1.1, SW1.2, SW2.1, SW2.2, T1.E (Emitter), T1.K (Cathode), T2.E (Emitter), T2.K (Cathode), T3.E (Emitter), T3.K (Cathode), T4.E (Emitter), T4.K (Cathode), T5.E (Emitter), T5.K (Cathode), T6.E (Emitter), T6.K (Cathode), T7.E (Emitter), T7.K (Cathode), T8.E (Emitter), T8.K (Cathode), T9.E (Emitter), T9.K (Cathode), T10.E (Emitter), T10.K (Cathode), T11.E (Emitter), T11.K (Cathode), T12.E (Emitter), T12.K (Cathode), T13.E (Emitter), T13.K (Cathode), T14.E (Emitter), T14.K (Cathode), T15.E (Emitter), T15.K (Cathode), T16.E (Emitter), T16.K (Cathode), U1.1 (GND1), U1.2 (GND1), U1.30 (GND1), U1.42 (GND1), U1.43 (GND1), U1.46 (GND1), U1.47 (GND1), U1.48 (GND1), U1.49 (GND1), U1.50 (GND1), U1.51 (GND1), U1.52 (GND1), U1.53 (GND1), U1.54 (GND1), U1.55 (GND1), U1.56 (GND2), U1.57 (GND2), U1.58 (GND2), U1.59 (GND2), U1.60 (GND2), U1.61_1 (GND2), U1.61_2 (GND2), U1.61_3 (GND2), U1.61_4 (GND2), U1.61_5 (GND2), U1.61_6 (GND2), U1.61_7 (GND2), U1.61_8 (GND2), U1.61_9 (GND2), U1.62 (GND2), U1.63 (GND3), U1.64 (GND3), U1.65 (GND3), U2.1 (ADJ)
unnamed: D1.2 (A), R36.2
unnamed: D2.2 (A), U1.41 (IO45)
unnamed: D2.1 (K), R37.2
unnamed: D5.2, D6.2 (A), J1.1 (VBUS)
unnamed: R1.2, T1.A (Anode)
unnamed: R2.2, T2.A (Anode)
unnamed: R3.2, T3.A (Anode)
unnamed: R4.2, T4.A (Anode)
unnamed: R9.2, T5.A (Anode)
unnamed: R10.2, T6.A (Anode)
unnamed: R11.2, T7.A (Anode)
unnamed: R12.2, T8.A (Anode)
unnamed: R17.2, T9.A (Anode)
unnamed: R18.2, T10.A (Anode)
unnamed: R19.2, T11.A (Anode)
unnamed: R20.2, T12.A (Anode)
unnamed: R25.2, T13.A (Anode)
unnamed: R26.2, T14.A (Anode)
unnamed: R27.2, T15.A (Anode)
unnamed: R28.2, T16.A (Anode)
