Potato-eater/Legacy2026/pcbs/line_sensor/line_sensor.kicad_pcb

## KiCad design pcbs/line_sensor/line_sensor.kicad_pcb (continued)

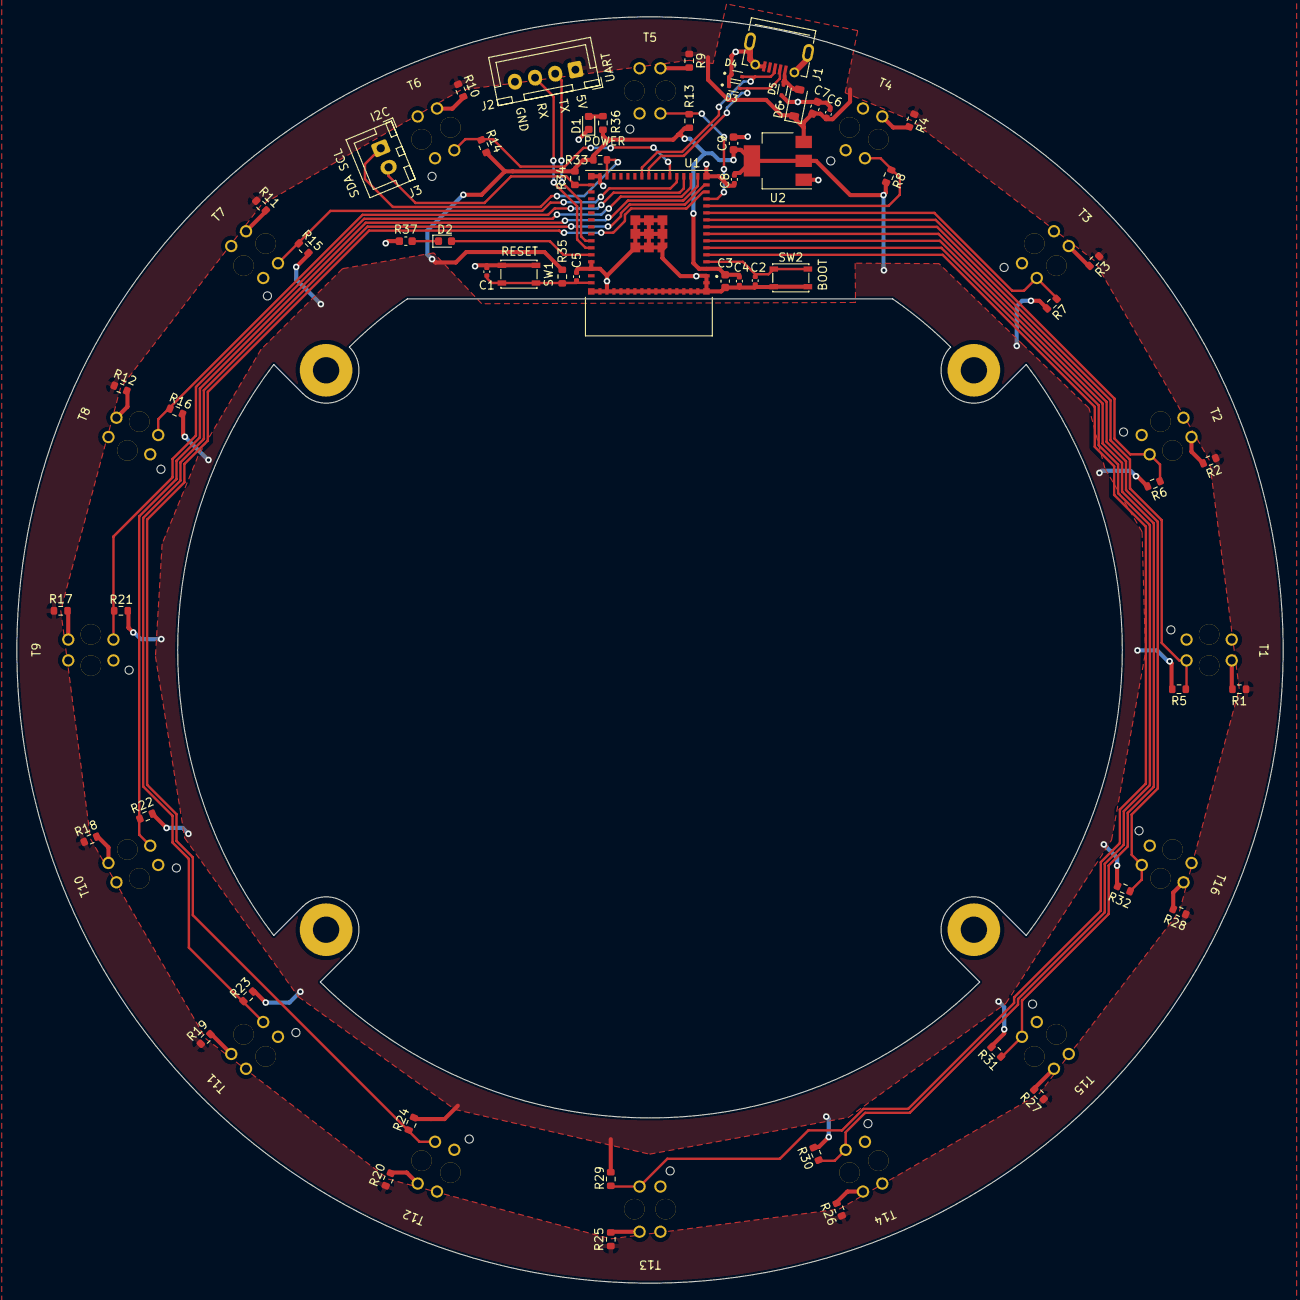
[picture p10: board line_sensor.kicad_pcb from above]

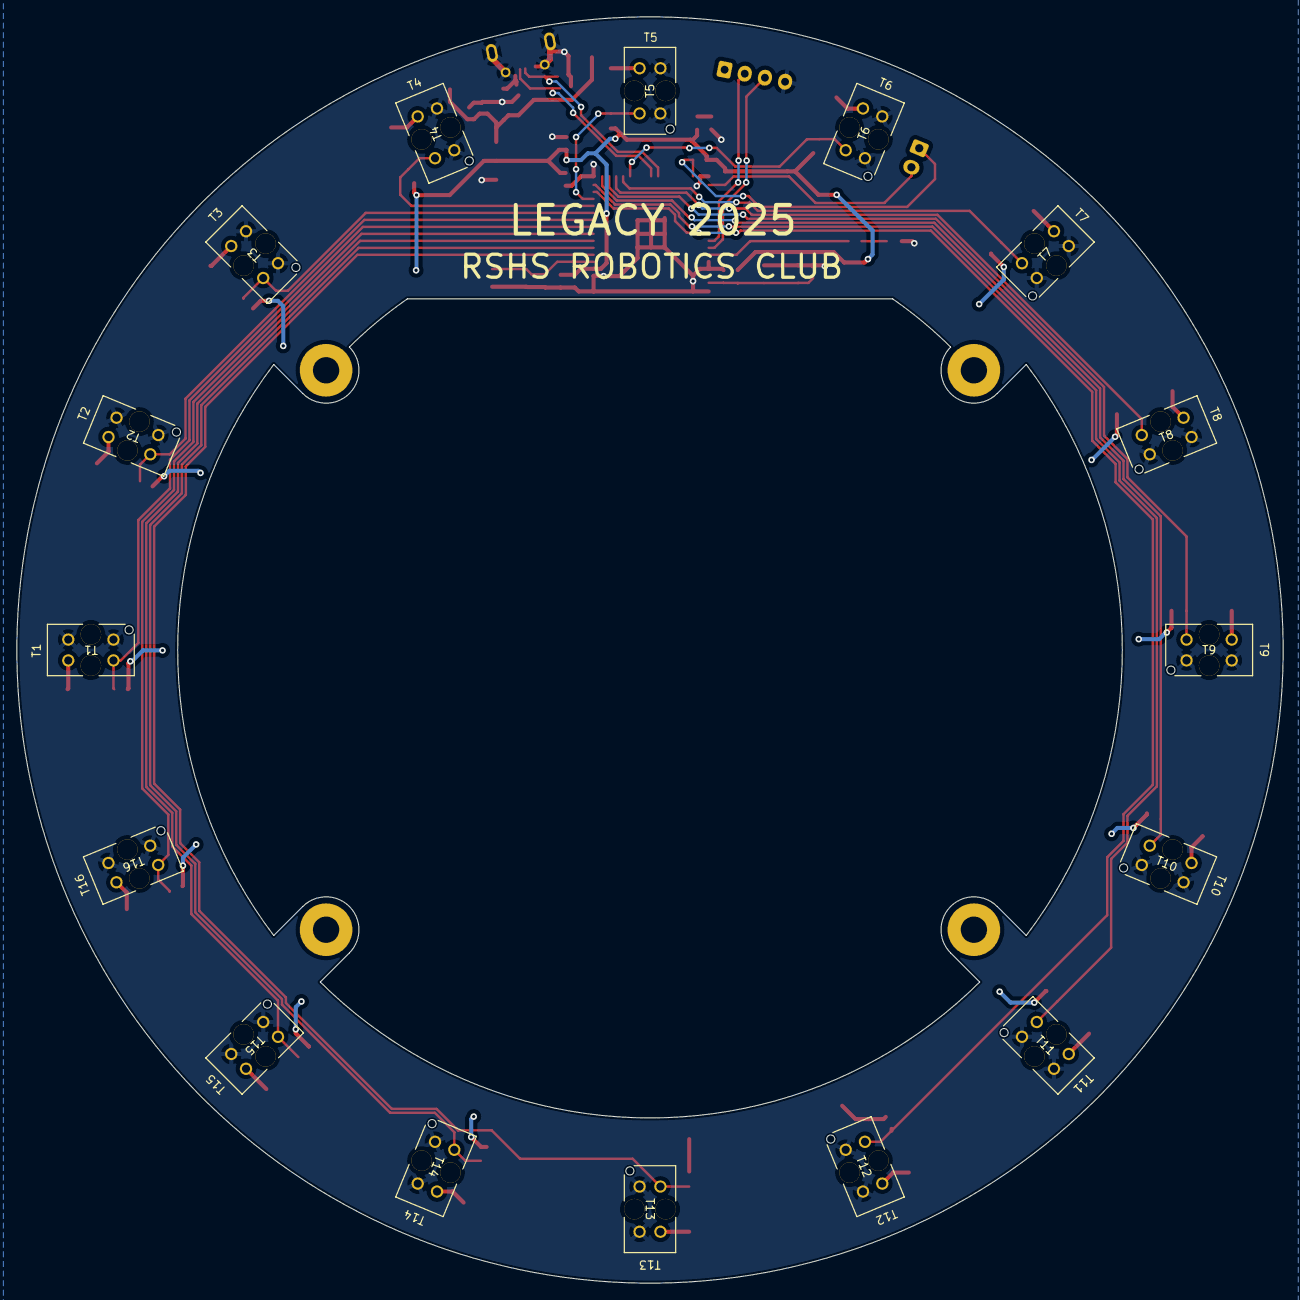
[picture p11: board line_sensor.kicad_pcb from below]

Board: 2 copper layers, 154.0 x 154.0 mm, 79 parts (16 on the bottom side), 47 nets.
