Potato-eater/Legacy2026/robot_program/src/main.cpp

// main code for the robots for team Legacy, 2026. We are team from Rossmoyne Senior High School.

// include all the libraries.
#include <Arduino.h>
#include <Wire.h>
#include <Adafruit_Sensor.h>
#include <Adafruit_BNO055.h>
#include <cmath>
#include <iostream>
#include <SoftwareSerial.h>

#include "position_system.hpp"
#include "pins.h"
#include "vector.hpp"
#include "motor_controller.hpp"
#include "ir_sensor.hpp"
#include "line_sensor.hpp"
#include "dribbler.hpp"
#include "mode.hpp"
#include "pid.hpp"
#include "camera.hpp"
#include "compute.hpp"
#include "vector2.hpp"
#include <SPI.h>
#include <Adafruit_GFX.h>
#include <Adafruit_SSD1306.h>

// pre-defining some functions.
bool set_robot_pos();
void print_botdata(BotData &bot_data, String message);
void set_goal_colour(bool *is_yellow);

// checks if the robot is on the line
void check_line(float heading, Vector line_vector, PositionSystem *pos_sys, float *move_angle) {
  if (line_vector.magnitude() != 0) {
    *move_angle = line_vector.heading() + M_PI;
  }
}


// init all the objects and variables.
// the arduino framework uses a setup and loop function,
// so we have to define everything as global if we need to use them across iterations.
IRSensor ir_sensor;
LineSensor line_sensor;
Camera camera;
PositionSystem pos_sys;
DribblerMotor dribbler(DR_DIR, DR_PWM);
MotorController motor_ctrl;

bool robot_start = false; // thie variable defines if the robot should move.
bool is_attack = false;

bool button_pressed = false; 
bool prev_robot_state = false;
// since we always leave the bno055 on, we never reset its value.
// we use this heading offset to determine where forwards is.
float heading_offset = 0;
// DribblerMotor dribbler(DR_DIR, DR_PWM);
Adafruit_SSD1306 display(128, 32, &Wire, -1);

// Modes
// using polymorphism, we can have different modes, that all returns the same datatype.

IndependentAttack independent_attack(AimMode::CAMERA_OTOS_MODE);
BetterDefend better_defend;
// OneRobot one_robot_mode;
// BetterDefend better_defend_mode;
// uint8_t previous_mode = 0;


int loop_time = 0;


float time_start = millis();
float time_end = millis();

int num_greater_than_other = 0;
int num_less_than_other = 0;

void setup() {
  // put your setup code here, to run once:

  // initialising UART communication and USB debugging.
  Serial.begin(921600);
  Serial1.begin(921600); // Line Sensor
  Serial6.begin(921600); // IR Sensor
  Serial3.begin(115200); // Camera
  // tbh i probably can make the camera baud rate faster but there isnt much point if the camera processes data slower than that anyway.


  // initialising GPIO
  pinMode(DEBUG_LED, OUTPUT);
  pinMode(TEENSY_LED, OUTPUT);

  // Drive motors
  pinMode(TL_PWM, OUTPUT); pinMode(TR_PWM, OUTPUT); pinMode(BL_PWM, OUTPUT); pinMode(BR_PWM, OUTPUT);
  analogWriteFrequency(TL_PWM, 20000); analogWriteFrequency(TR_PWM, 20000);
  analogWriteFrequency(BL_PWM, 20000); analogWriteFrequency(BR_PWM, 20000);
  pinMode(TL_DIR, OUTPUT); pinMode(TR_DIR, OUTPUT); pinMode(BL_DIR, OUTPUT); pinMode(BR_DIR, OUTPUT);

  // make sure all the driver motors are stopped.
  motor_ctrl.stop_motors();

  // Start buttons
  // high means not pressed, low means pressed.
  pinMode(BTN_1, INPUT_PULLUP);
  pinMode(BTN_2, INPUT_PULLUP);
  pinMode(BTN_3, INPUT_PULLUP);
  pinMode(BTN_4, INPUT_PULLUP);
  pinMode(BTN_5, INPUT_PULLUP);

  pinMode(BTN_RUN, INPUT_PULLUP);

  // Dribbler pins
  pinMode(DR_PWM, OUTPUT);
  pinMode(DR_DIR, OUTPUT);

  pos_sys.setup(); // initialise the bno055 gyro and sparkfun OTOS
  pos_sys.set_pos(Vector(0, -80), 0);
  // we dont actually use the display all the time. If it is installed, it would display info.
  // After extensive testing, we found that we cannot really put live data onto this screen,
  // It updates a bit too slow, the other functions cannot run until its done.
  // Display Setup
  display.begin(SSD1306_SWITCHCAPVCC, 0x3C); // average i2c device
  display.setRotation(2);     
  display.setTextColor(SSD1306_WHITE);
  display.cp437(true);  

  // Displaying Ready and compile date/time
  display.clearDisplay();
  display.setTextSize(2);
  display.setCursor(0, 0);   
  display.println("Ready");
  display.setTextSize(1);
  display.setCursor(0, 20);
  display.print(__DATE__); display.print(" "); display.println(__TIME__);
  display.display();

  Serial.println("Awaiting button press");

  camera.facing_yellow = true;
  better_defend.reset();
}


void loop() {
  // Serial.println("hello world");
  set_robot_pos();
  set_goal_colour(&camera.facing_yellow);
  robot_start = !digitalReadFast(BTN_RUN);
  if (robot_start && prev_robot_state == false) {  
    heading_offset = pos_sys.get_heading();
  }

  line_sensor.update();
  ir_sensor.update();
  pos_sys.update();
  camera.update();
  float heading = pos_sys.get_heading() - heading_offset;
  while (heading >= PI) heading -= 2 * PI;
  while (heading <= -PI) heading += 2 * PI;
  // make sure its -pi to pi
  // modulo % in c++ doesnt work the same way as python. therefore we need this while true approach.

  ir_sensor.angle_correction(heading);
  line_sensor.angle_correction(heading); // make ir and line sensor account for robot tilt.


  float ir_angle = ir_sensor.get_angle();
  while (ir_angle < -PI) ir_angle += 2*PI;
  while (ir_angle > PI) ir_angle -= 2*PI;

  if (ir_sensor.get_magnitude() == 0) { // if the ball is not seen, there cannot be an angle.
    ir_angle = 0;
  }
  BotData self_data = {
    .heading = heading,
    .pos_vector = pos_sys.get_posv(),
    .ball_strength = ir_sensor.get_magnitude(),
    .ball_angle = ir_angle,
    .line_vector = Vector::from_heading(line_sensor.get_angle(), line_sensor.get_distance()),
    .velocity = Vector(0.0, 0.0),
    .goal_x = camera.goal_x,
  };

  line_sensor.send_bot_data(self_data); // send data to the other robot via the line sensor.
  BotData other_data = line_sensor.other_data;

  OutputData output = independent_attack .update(self_data, other_data, 0.0);
  // String current_mode = "defend";
  // OutputData output = better_defend.update(self_data, other_data, 0.0);
  // if (self_data.ball_strength > other_data.ball_strength) {
  //   num_greater_than_other++;
  // }
  // else {
  //   num_greater_than_other = 0;
  // }
  // if (num_greater_than_other >= 300) {
  //   output = independent_attack.update(self_data, other_data, 0.0);
  //   current_mode = "attack";
  //   is_attack = true;
  // }
  // else {
  //   is_attack = false;
  // }
  // if (self_data.ball_strength == 0 && is_attack) {
  //   output = independent_attack.update(self_data, other_data, 0.0);
  //   current_mode = "attack";
  // }
  
  check_line(self_data.heading, self_data.line_vector, &pos_sys, &output.angle); // stops the robot from getting out of the line.
  

  if (!robot_start) {
    // speed = 0;
    motor_ctrl.stop_motors();
  }
  else {
    motor_ctrl.run_motors(100.0, output.angle, output.rotation); 
  }

  
  // Serial.printf("dribbler on: %d\n", output.dribbler_on);

  if (output.dribbler_on && !(RELEASE_BALL && self_data.pos_vector.j >= SLOW_DOWN_DIST-5) && robot_start) {
    dribbler.run();
  }
  else if (output.dribbler_on && self_data.pos_vector.j >= SLOW_DOWN_DIST-5 && RELEASE_BALL && robot_start) {
    dribbler.run_reverse();
    output.speed = RELEASE_SPEED;
  }
  else {
    dribbler.stop();
  }

  prev_robot_state = robot_start;
  // dribbler.stop();

  digitalWrite(DEBUG_LED, HIGH);
  digitalWrite(TEENSY_LED, camera.facing_yellow);
  // Serial.printf("%d\n", num_greater_than_other);
  // Serial.println(current_mode);
}

void set_goal_colour(bool *is_yellow) {
  if (!digitalRead(BTN_1) && !digitalRead(BTN_5)) {
    *is_yellow = false;
  }
  if (!digitalRead(BTN_2) && !digitalRead(BTN_4)) {
    *is_yellow = true;
  }
}

bool set_robot_pos() {
  if (!digitalRead(BTN_1)) {
    pos_sys.set_pos(Vector(0, -14.5), 0); // set position of otos (kick off)
    return true;
  }
  if (!digitalRead(BTN_2)) {
    pos_sys.set_pos(Vector(-49, -61.5), 0); // set position of otos (def left)
    return true;
  }
  if (!digitalRead(BTN_3)) {
    pos_sys.set_pos(Vector(0, -61.5), 0); // set position of otos (center front)
    return true;
  }
  if (!digitalRead(BTN_4)) {
    pos_sys.set_pos(Vector(49, -61.5), 0); // set position of otos (def right)
    return true;
  }
  if (!digitalRead(BTN_5)) {
    pos_sys.set_pos(Vector(0, -80), 0); // set position of otos (center back)
    return true;
  }
  return false;
}

void print_botdata(BotData &bot_data, String message) {
  Serial.print(message + " | heading:");
  Serial.print(bot_data.heading*180/PI);
  Serial.print(" posv:<");
  Serial.print(bot_data.pos_vector.i);
  Serial.print(",");
  Serial.print(bot_data.pos_vector.j);
  Serial.print("> strength:");
  Serial.print(bot_data.ball_strength);
  Serial.print(" IR angle:");
  Serial.print(bot_data.ball_angle*180/PI);
  Serial.print(" line angle:");
  Serial.print(bot_data.line_vector.heading()*180/PI);
  Serial.print(" line distance:");
  Serial.println(bot_data.line_vector.magnitude());
}
