Potato-eater/Legacy2026/esp_programs/line_sensor_bluetooth/main/constants.hpp

#define EXAMPLE_READ_LEN           512
#define EXAMPLE_ADC_OUTPUT_TYPE    ADC_DIGI_OUTPUT_FORMAT_TYPE2
#define CHANNEL_NUM                16  // 2 from ADC1, 2 from ADC2
#define TX 43
#define RX 44
#define UART_PORT_NUM UART_NUM_1
#define BAUD_RATE 921600
#define UART_BUF_SIZE (2048)

// which pin corresponds to which adc channel
// have a look at https://docs.google.com/document/d/1iV03XgA_sWDZuUIY8wmpyr5PnYlAYuVsP58qxx857lA/edit?tab=t.0

#define IO1 0 // adc 1
#define IO2 1 // adc 1
#define IO3 2 // adc 1
#define IO4 3 // adc 1
#define IO5 4 // adc 1
#define IO6 5 // adc 1
#define IO7 6 // adc 1
#define IO8 7 // adc 1
#define IO9 8 // adc 1
#define IO10 9 // adc 1
#define IO11 0 // adc 2
#define IO12 1 // adc 2
#define IO13 2 // adc 2
#define IO14 3 // adc 2
#define IO15 4 // adc 2
#define IO16 5 // adc 2

#define TCRT1 IO5  // adc 1
#define TCRT2 IO6 // adc 1
#define TCRT3 IO7 // adc 1
#define TCRT4 IO8 // adc 1
#define TCRT5 IO9 // adc 1
#define TCRT6 IO16 // adc 2
#define TCRT7 IO15 // adc 2
#define TCRT8 IO14 // adc 2
#define TCRT9 IO13 // adc 2
#define TCRT10 IO12 // adc 2
#define TCRT11 IO11 // adc 2
#define TCRT12 IO10 // adc 1
#define TCRT13 IO1 // adc 1
#define TCRT14 IO2 // adc 1
#define TCRT15 IO3 // adc 1
#define TCRT16 IO4 // adc 1
