Potato-eater/Legacy2026/robot_program/include/pins.h

// this file defines all the digital pins.

// drive motors
#define TL_PWM 33
#define TL_DIR 34
#define TR_PWM 29
#define TR_DIR 31
#define BL_PWM 22
#define BL_DIR 23
#define BR_PWM 2
#define BR_DIR 3

// run button
#define BTN_RUN 5

// debugging led
#define DEBUG_LED 17
#define TEENSY_LED 13

#define BTN_1 6 // front button
#define BTN_2 12 // left button
#define BTN_3 10 // center button
#define BTN_4 9 // right button
#define BTN_5 11 // back button

#define DR_PWM 7
#define DR_DIR 8
