Potato-eater/Legacy2026/(commit log)

2026-04-11 added ir sensor and ir visualiser
2026-07-15 changed line sensor stuff
2026-08-17 changed dribbler and motors
2026-08-22 added slow down and reversed dribbler direction
    [constants.h, main.cpp]
2026-09-26 added camera stuff
2026-09-26 camera finally works!!!
2026-09-28 added pcb stuff and other updates
    [bom.csv, control_board.kicad_pcb, control_board.kicad_sch, control_board.step, control_board.stl, designators.csv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]
2026-09-28 Added Mid-range attack modes for OTOS & CAMERA
2026-10-01 fixed role switching
